islathehut/isla-kbd/README.md

# isla-kbd

This repo is for collecting my keyboard designs.

## Keyboards

* [sandevistan43](./sandevistan43/README.md)

## Development

Run `make` to install submodules.

_NOTE: Designs were made with Kicad 9_
