islathehut/isla-kbd/sandevistan58/README.md

# sandevistan43

A 43-key split keyboard inspired by the [corne](https://github.com/foostan/crkbd), [torn](https://github.com/rtitmuss/torn), and [0xCB Static](https://0xcb.dev/static/).

> :warning: **Warning:** This is very much a work in progress!  Use these designs at your own risk!

# Features

* corne stagger 3x6 main rows
* 4 and 3-key splayed thumb rows
* 2" IPS display
* 34mm-55mm trackball via [vik](https://github.com/sadekbaroudi/vik) and dedicated left and right mouse buttons
* Support for hotswapped Choc V1/V2, Gateron Low Profile KS-27/KS-33, and Cherry MX switches
* RaspberryPi Pico controllers<sup>1</sup>
* Top-mounted through-hole diodes
* [vik](https://github.com/sadekbaroudi/vik) support on the right side allows the use of [any vik module](https://github.com/sadekbaroudi/vik/tree/master/pcb)<sup>2</sup>

_<span style="color:gray"><sup>1</sup>Must use a Pico or Pico-clone with castellated pads</br><sup>2</sup>Firmware modifications are required if using the vik connector for something other than a trackball </span>_

# Materials

| Part Name | Count |
| ---  | --- |
| Choc/MX/GLP Hotswap Sockets | 43 |
| Key Switches | 43 |
| [1N4148 Through-hole Diodes](https://www.digikey.com/en/products/detail/diotec-semiconductor/1N4148/13164514) | 43 |
| [SJ2-35954A-SMT-TR TRRS Jack](https://www.digikey.com/en/products/detail/same-sky-formerly-cui-devices/SJ2-35954A-SMT-TR/6619576) | 2 |
| [TL6340AF160Q Reset Button](https://www.digikey.com/en/products/detail/e-switch/TL6340AF160Q/11684842) | 2 |
| [DFR0664 2" Display](https://www.digikey.com/en/products/detail/dfrobot/DFR0664/13166503) | 1 |
| [Mill-Max 10-pin Socket](https://www.digikey.com/en/products/detail/digikey-va/310-13-110-41-001000/265817) | 1 |
| [Mill-Max 10-pin Header](https://www.digikey.com/en/products/detail/digikey-va/350-10-110-00-006000/4456131) | 1 |
| [Amphenol 12-pin FPC Connector](https://www.digikey.com/en/products/detail/amphenol-cs-fci/F3311A7H121012E200/15287510) | 1 |
| [Amphenol 4-pin FPC Connector](https://www.digikey.com/en/products/detail/amphenol-cs-fci/F3311A7H121004E200/15287508) | 1 |
| 12-pin FFC Cable (same or opposite side orientation works) | 1 |
| 4-pin FFC Cable (same or opposite side orientation works) | 1 |
| 3-pole Mouse Micro Switch (e.g. [Kailh GM](https://www.lethal.gg/products/kailh-gm-2-0-teal-micro-switch-2-pcs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)) | 2 |
| [fingerpunch PMW3360 XS Trackball PCB](https://fingerpunch.xyz/product/vik-pmw3360-trackball-module-xs/) | 1 |
| 34mm Trackball | 1 |
| TRRS Cable | 1 |
| USB-C Cable | 1 |
| Left PCB | 1 |
| Right PCB | 1 |
| Switch plate | 2 |
| Left Base Plate | 1 |
| Right Base Plate | 1 |
| Assorted M2 standoffs and screws | TBD |
| Trackball mount | 1 |

For now the trackball is in development and the mouse keys are one of the next things on my list.

# Firmware

_Coming soon_
