islathehut/isla-kbd/kicad/footprints/Mounting Hole/README.md

# Mounting_Holes.pretty

Credit to https://kicad.github.io/footprints/MountingHole.html
