islathehut/isla-kbd/kicad/footprints/Amphenol F3311A7H121004E200 4-pin FPC Connector/Amphenol F3311A7H121004E200 3D Model STEP 510211.STEP

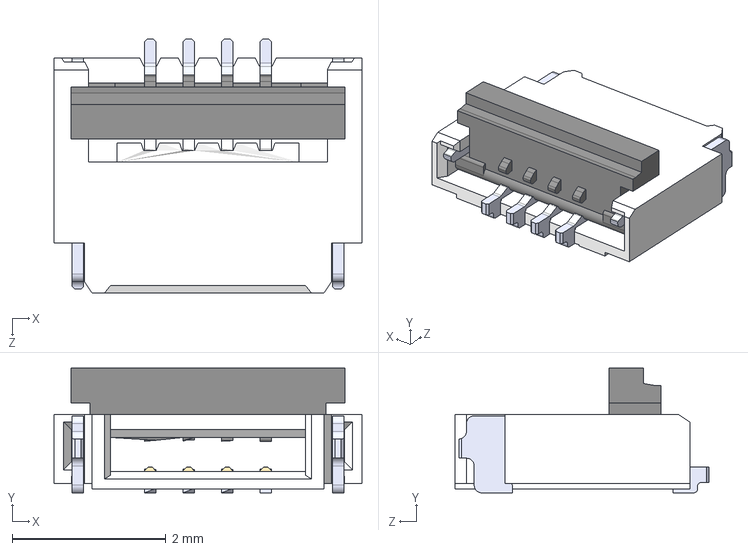
[picture p1: CAD file, 2025-05-30]
kicad/footprints/Amphenol F3311A7H121004E200 4-pin FPC Connector/Amphenol F3311A7H121004E200 3D Model STEP 510211.STEP
4.00 x 1.62 x 3.30 mm
