islathehut/isla-kbd/kicad/footprints/Amphenol F3311A7H121012E200 12-pin FPC Connector/F3311A7H121012E200 3D Model STEP 510211.STEP

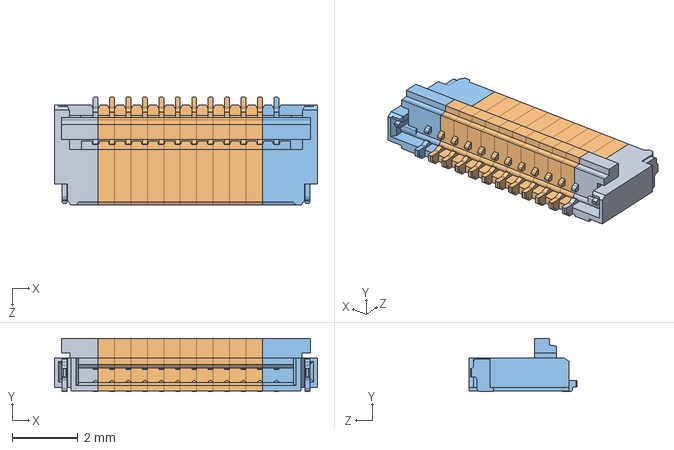
[picture p2: CAD file, 2025-05-30]
kicad/footprints/Amphenol F3311A7H121012E200 12-pin FPC Connector/F3311A7H121012E200 3D Model STEP 510211.STEP
8.00 x 1.62 x 3.30 mm
