islathehut/isla-kbd/kicad/footprints/EVQ-P7C01P/EVQ-P7C01P.step

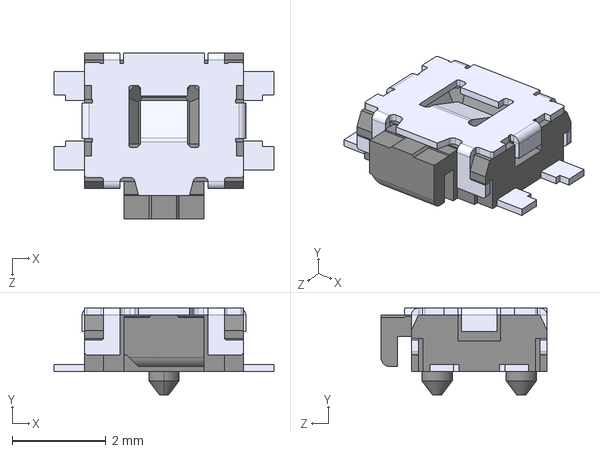
[picture p3: CAD file, 2025-06-11]
kicad/footprints/EVQ-P7C01P/EVQ-P7C01P.step
4.70 x 1.85 x 3.55 mm
