islathehut/isla-kbd/kicad/footprints/PEC11R 4215F Footprint Symbol/PEC11R-4215F-S0024.step

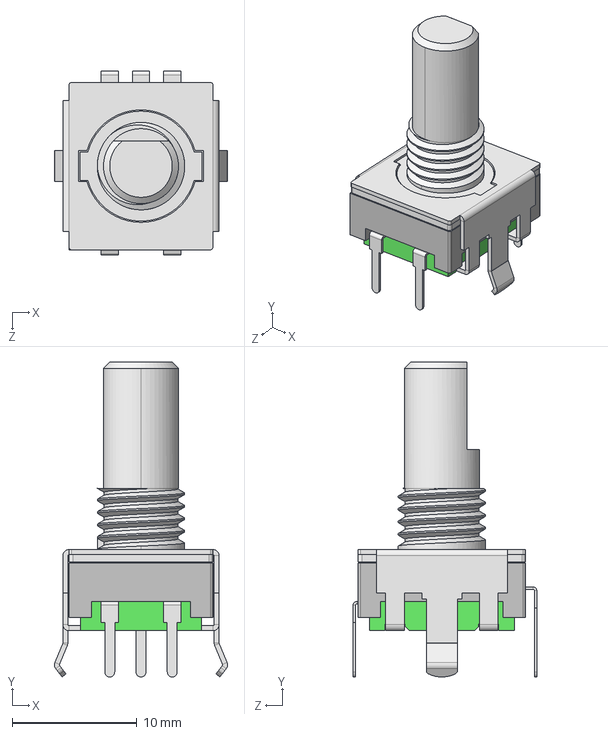
[picture p4: CAD file, 2025-06-02]
kicad/footprints/PEC11R 4215F Footprint Symbol/PEC11R-4215F-S0024.step
13.9 x 25.2 x 14.7 mm
