islathehut/isla-kbd/kicad/footprints/SJ2 35954A SMT TR SMD TRRS Jack/Same_Sky_SJ2-35954A-SMT-TR.step

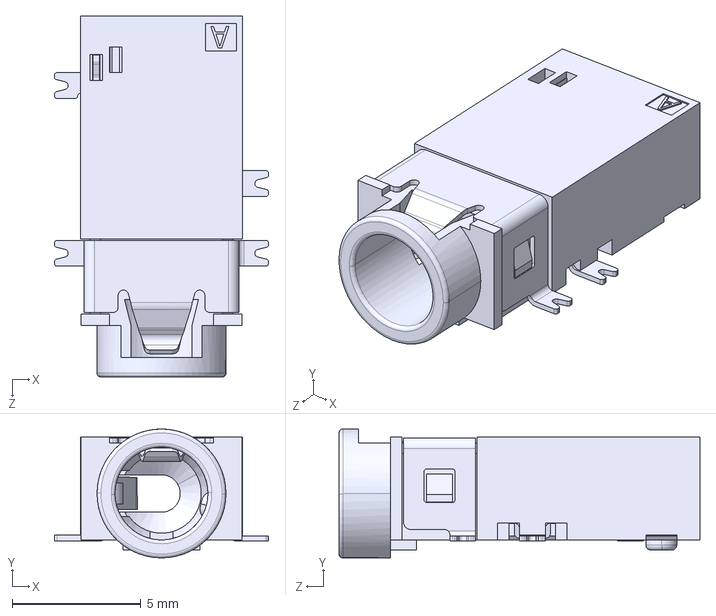
[picture p5: CAD file, 2025-05-30]
kicad/footprints/SJ2 35954A SMT TR SMD TRRS Jack/Same_Sky_SJ2-35954A-SMT-TR.step
8.30 x 5.00 x 14.0 mm
