islathehut/isla-kbd/kicad/footprints/TL6340AF160Q SMD Reset Switch/TL6340AF160Q.step

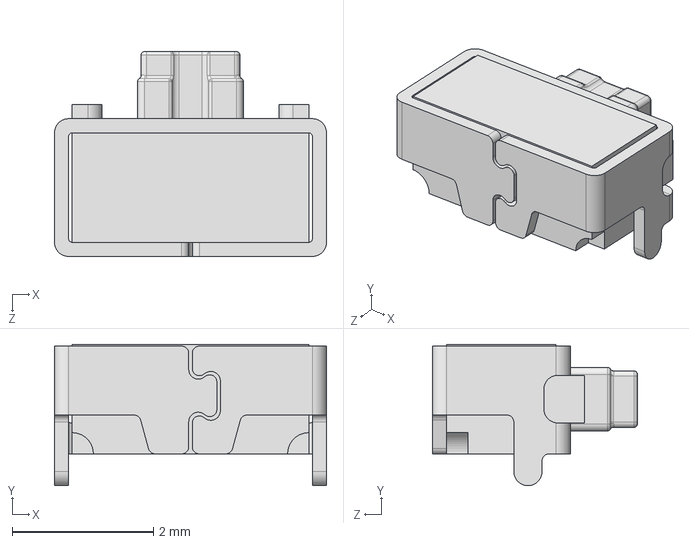
[picture p6: CAD file, 2025-05-30]
kicad/footprints/TL6340AF160Q SMD Reset Switch/TL6340AF160Q.step
3.85 x 2.00 x 2.90 mm
