islathehut/isla-kbd/sandevistan58/stl/trackball/55mm_btu_trackball_ball_mount_v1.stl

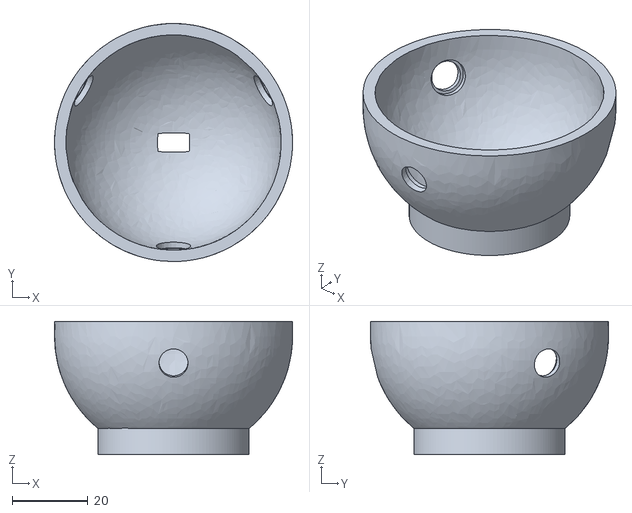
[picture p7: CAD file, 2025-06-11]
sandevistan58/stl/trackball/55mm_btu_trackball_ball_mount_v1.stl
63.0 x 63.0 x 35.3
