islathehut/isla-kbd/kicad/footprints/Amphenol F3311A7H121012E200 12-pin FPC Connector/Molex 3D Model STEP 56544.STEP

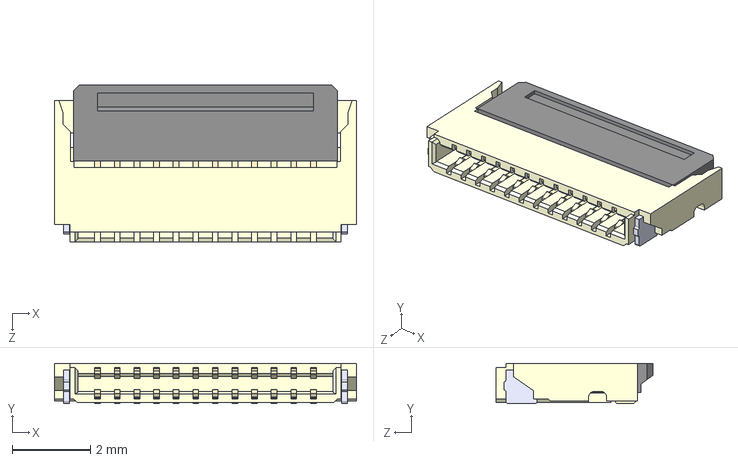
[picture p8: CAD file, 2025-05-30]
kicad/footprints/Amphenol F3311A7H121012E200 12-pin FPC Connector/Molex 3D Model STEP 56544.STEP
7.70 x 1.02 x 4.00 mm
