islathehut/isla-kbd/sandevistan58/stl/trackball/trackball_pcb_mount_v1.stl

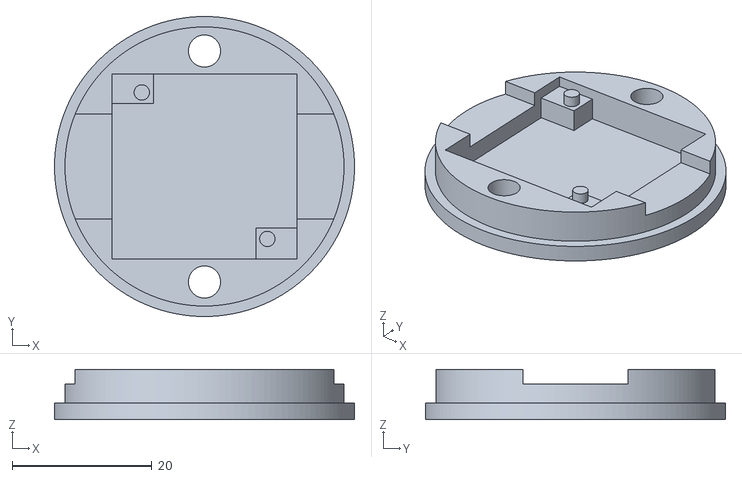
[picture p9: CAD file, 2025-05-30]
sandevistan58/stl/trackball/trackball_pcb_mount_v1.stl
43.0 x 43.0 x 7.19
