islathehut/isla-kbd/sandevistan58/stl/trackball/34mm_btu_trackball_ball_mount_v1.stl

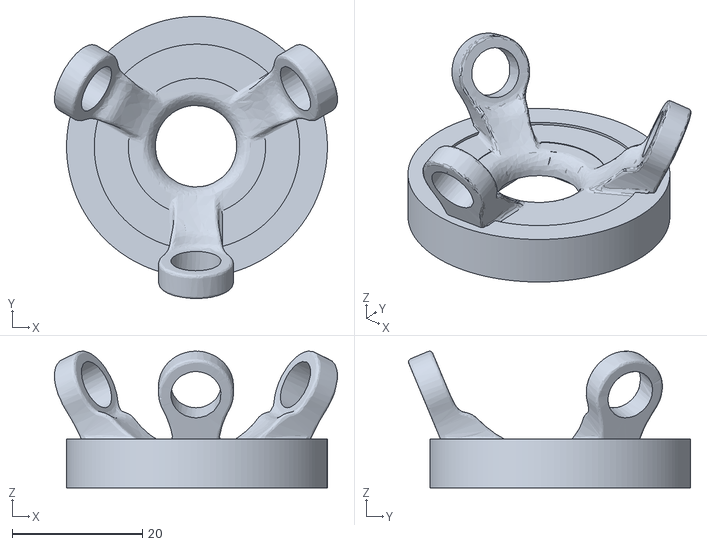
[picture p10: CAD file, 2025-05-30]
sandevistan58/stl/trackball/34mm_btu_trackball_ball_mount_v1.stl
43.4 x 43.3 x 21.0
