islathehut/isla-kbd/sandevistan58/pcb/sandevistan58_right.kicad_sch

## KiCad design sandevistan58/pcb/sandevistan58_right.kicad_sch (2025-06-11)

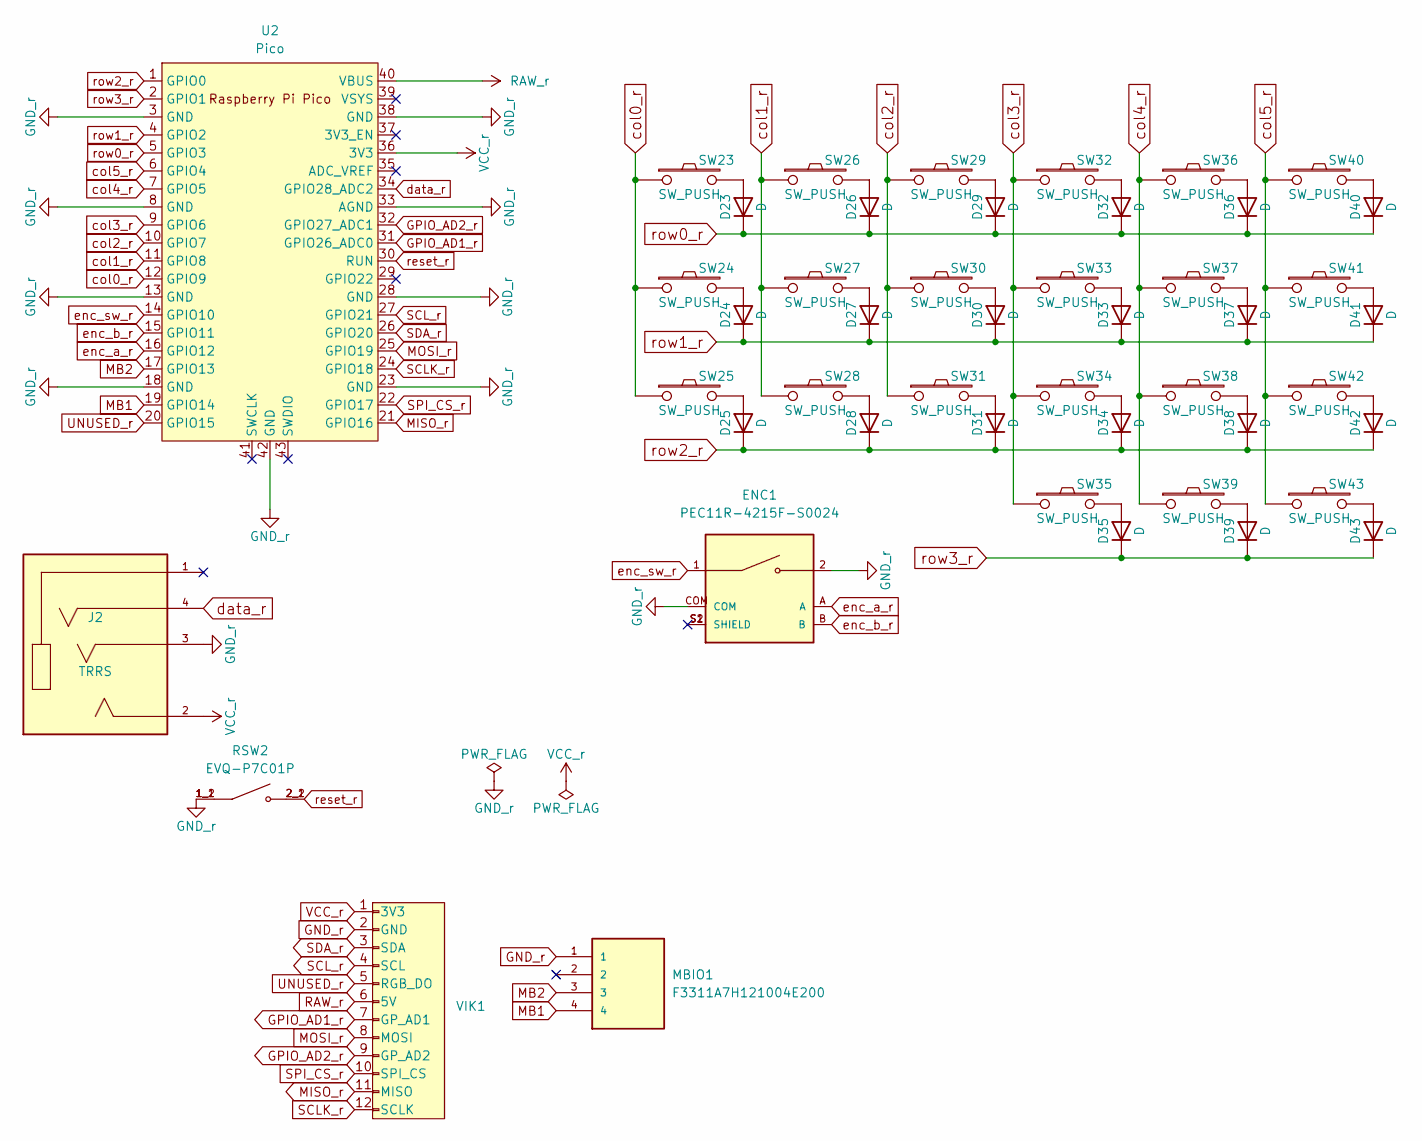
[picture p12: schematic sandevistan58_right.kicad_sch]

Parts:
D23, D24, D25, D26, D27, D28, D29, D30, D31, D32, D33, D34, D35, D36, D37, D38, D39, D40, D41, D42, D43: D; TH 1N4148 Diode (long)
ENC1: PEC11R-4215F-S0024; PEC11R_23mm_knob; PARTREV Rev. 09/19
J2: TRRS; CUI_SJ2-35954A-SMT-TR; PARTREV 1.04
MBIO1: F3311A7H121004E200; AMPHENOL_F3311A7H121004E200; PARTREV A
RSW2: EVQ-P7C01P; SW_EVQ-P7C01P; PARTREV 2022.4
SW23, SW24, SW25, SW26, SW27, SW28, SW29, SW30, SW31, SW32, SW33, SW34, SW35, SW36, SW37, SW38, SW39, SW40, SW41, SW42: SW_PUSH; Universal Switch Footprint (1u)
SW43: SW_PUSH; Universal Switch Footprint (1.5u)
U2: Pico; RPi_Pico_SMD_TH_no_through_holes
VIK1: vik-keyboard-connector-horizontal-mini

Connections:
GND_r: ENC1.2, ENC1.COM, J2.3, MBIO1.1, RSW2.1_1, RSW2.1_2, U2.3 (GND), U2.8 (GND), U2.13 (GND), U2.18 (GND), U2.23 (GND), U2.28 (GND), U2.33 (AGND), U2.38 (GND), U2.42 (GND), VIK1.2 (GND)
GPIO_AD1_r: U2.31 (GPIO26_ADC0), VIK1.7 (GP_AD1)
GPIO_AD2_r: U2.32 (GPIO27_ADC1), VIK1.9 (GP_AD2)
MB1: MBIO1.4, U2.19 (GPIO14)
MB2: MBIO1.3, U2.17 (GPIO13)
MISO_r: U2.21 (GPIO16), VIK1.11 (MISO)
MOSI_r: U2.25 (GPIO19), VIK1.8 (MOSI)
unnamed: D23.2 (A), SW23.2
unnamed: D24.2 (A), SW24.2
unnamed: D25.2 (A), SW25.2
unnamed: D26.2 (A), SW26.2
unnamed: D27.2 (A), SW27.2
unnamed: D28.2 (A), SW28.2
unnamed: D29.2 (A), SW29.2
unnamed: D30.2 (A), SW30.2
unnamed: D31.2 (A), SW31.2
unnamed: D32.2 (A), SW32.2
unnamed: D33.2 (A), SW33.2
unnamed: D34.2 (A), SW34.2
unnamed: D35.2 (A), SW35.2
unnamed: D36.2 (A), SW36.2
unnamed: D37.2 (A), SW37.2
unnamed: D38.2 (A), SW38.2
unnamed: D39.2 (A), SW39.2
unnamed: D40.2 (A), SW40.2
unnamed: D41.2 (A), SW41.2
unnamed: D42.2 (A), SW42.2
unnamed: D43.2 (A), SW43.2
unnamed: ENC1.S1 (SHIELD), ENC1.S2 (SHIELD)
RAW_r: U2.40 (VBUS), VIK1.6 (5V)
SCLK_r: U2.24 (GPIO18), VIK1.12 (SCLK)
SCL_r: U2.27 (GPIO21), VIK1.4 (SCL)
SDA_r: U2.26 (GPIO20), VIK1.3 (SDA)
SPI_CS_r: U2.22 (GPIO17), VIK1.10 (SPI_CS)
UNUSED_r: U2.20 (GPIO15), VIK1.5 (RGB_DO)
VCC_r: J2.2, U2.36 (3V3), VIK1.1 (3V3)
col0_r: SW23.1, SW24.1, SW25.1, U2.12 (GPIO9)
col1_r: SW26.1, SW27.1, SW28.1, U2.11 (GPIO8)
col2_r: SW29.1, SW30.1, SW31.1, U2.10 (GPIO7)
col3_r: SW32.1, SW33.1, SW34.1, SW35.1, U2.9 (GPIO6)
col4_r: SW36.1, SW37.1, SW38.1, SW39.1, U2.7 (GPIO5)
col5_r: SW40.1, SW41.1, SW42.1, SW43.1, U2.6 (GPIO4)
data_r: J2.4, U2.34 (GPIO28_ADC2)
enc_a_r: ENC1.A, U2.16 (GPIO12)
enc_b_r: ENC1.B, U2.15 (GPIO11)
enc_sw_r: ENC1.1, U2.14 (GPIO10)
reset_r: RSW2.2_1, RSW2.2_2, U2.30 (RUN)
row0_r: D23.1 (K), D26.1 (K), D29.1 (K), D32.1 (K), D36.1 (K), D40.1 (K), U2.5 (GPIO3)
row1_r: D24.1 (K), D27.1 (K), D30.1 (K), D33.1 (K), D37.1 (K), D41.1 (K), U2.4 (GPIO2)
row2_r: D25.1 (K), D28.1 (K), D31.1 (K), D34.1 (K), D38.1 (K), D42.1 (K), U2.1 (GPIO0)
row3_r: D35.1 (K), D39.1 (K), D43.1 (K), U2.2 (GPIO1)
