islathehut/isla-kbd/sandevistan43/pcb/sandevistan43_left.kicad_sch

## KiCad design sandevistan43/pcb/sandevistan43_left.kicad_sch (2025-06-11)

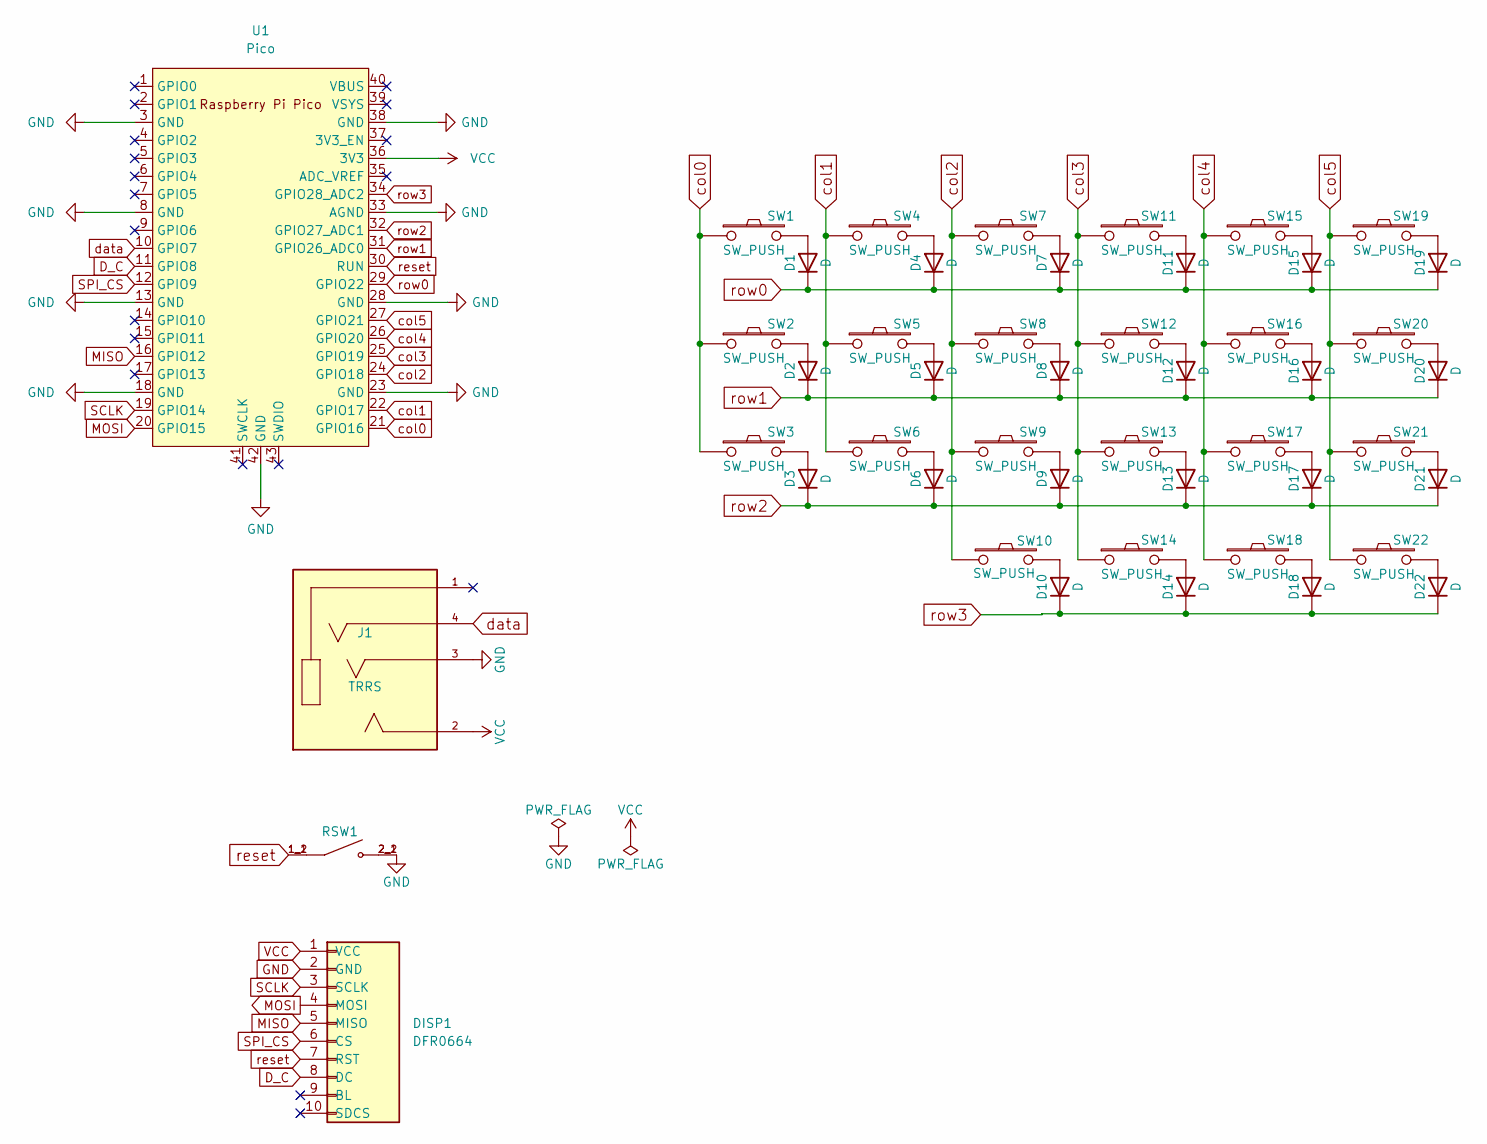
[picture p13: schematic sandevistan43_left.kicad_sch]

Parts:
D1, D2, D3, D4, D5, D6, D7, D8, D9, D10, D11, D12, D13, D14, D15, D16, D17, D18, D19, D20, D21, D22: D; TH 1N4148 Diode (long)
DISP1: DFR0664; DFR0664_2in_RGB_TFT_Display
J1: TRRS; CUI_SJ2-35954A-SMT-TR; PARTREV 1.04
RSW1: SW_PUSH; SW_EVQ-P7C01P; PARTREV 2022.4
SW1, SW2, SW3, SW4, SW5, SW6, SW7, SW8, SW9, SW10, SW11, SW12, SW13, SW14, SW15, SW16, SW17, SW18, SW19, SW20, SW21: SW_PUSH; Universal Switch Footprint (1u)
SW22: SW_PUSH; Universal Switch Footprint (1.5u)
U1: Pico; RPi_Pico_SMD_TH_no_through_holes

Connections:
D_C: DISP1.8 (DC), U1.11 (GPIO8)
GND: DISP1.2 (GND), J1.3, RSW1.2_1, RSW1.2_2, U1.3 (GND), U1.8 (GND), U1.13 (GND), U1.18 (GND), U1.23 (GND), U1.28 (GND), U1.33 (AGND), U1.38 (GND), U1.42 (GND)
MISO: DISP1.5 (MISO), U1.16 (GPIO12)
MOSI: DISP1.4 (MOSI), U1.20 (GPIO15)
unnamed: D1.2 (A), SW1.2
unnamed: D2.2 (A), SW2.2
unnamed: D3.2 (A), SW3.2
unnamed: D4.2 (A), SW4.2
unnamed: D5.2 (A), SW5.2
unnamed: D6.2 (A), SW6.2
unnamed: D7.2 (A), SW7.2
unnamed: D8.2 (A), SW8.2
unnamed: D9.2 (A), SW9.2
unnamed: D10.2 (A), SW10.2
unnamed: D11.2 (A), SW11.2
unnamed: D12.2 (A), SW12.2
unnamed: D13.2 (A), SW13.2
unnamed: D14.2 (A), SW14.2
unnamed: D15.2 (A), SW15.2
unnamed: D16.2 (A), SW16.2
unnamed: D17.2 (A), SW17.2
unnamed: D18.2 (A), SW18.2
unnamed: D19.2 (A), SW19.2
unnamed: D20.2 (A), SW20.2
unnamed: D21.2 (A), SW21.2
unnamed: D22.2 (A), SW22.2
SCLK: DISP1.3 (SCLK), U1.19 (GPIO14)
SPI_CS: DISP1.6 (CS), U1.12 (GPIO9)
VCC: DISP1.1 (VCC), J1.2, U1.36 (3V3)
col0: SW1.1, SW2.1, SW3.1, U1.21 (GPIO16)
col1: SW4.1, SW5.1, SW6.1, U1.22 (GPIO17)
col2: SW7.1, SW8.1, SW9.1, SW10.1, U1.24 (GPIO18)
col3: SW11.1, SW12.1, SW13.1, SW14.1, U1.25 (GPIO19)
col4: SW15.1, SW16.1, SW17.1, SW18.1, U1.26 (GPIO20)
col5: SW19.1, SW20.1, SW21.1, SW22.1, U1.27 (GPIO21)
data: J1.4, U1.10 (GPIO7)
reset: DISP1.7 (RST), RSW1.1_1, RSW1.1_2, U1.30 (RUN)
row0: D1.1 (K), D4.1 (K), D7.1 (K), D11.1 (K), D15.1 (K), D19.1 (K), U1.29 (GPIO22)
row1: D2.1 (K), D5.1 (K), D8.1 (K), D12.1 (K), D16.1 (K), D20.1 (K), U1.31 (GPIO26_ADC0)
row2: D3.1 (K), D6.1 (K), D9.1 (K), D13.1 (K), D17.1 (K), D21.1 (K), U1.32 (GPIO27_ADC1)
row3: D10.1 (K), D14.1 (K), D18.1 (K), D22.1 (K), U1.34 (GPIO28_ADC2)
