islathehut/isla-kbd/(commit log)

2025-05-31 Start rev0.2 build
    - pi pico replaces pro micro style mcu
    - mcu now on underside
    - rewire for simplicity
    - update switch footprints to allow choc, mx, gateron lp
    [sandevistan44_left.kicad_sch]
2025-06-02 Finish first iteration of 0.2 configuration
    - Add encoders on each side and add body extension
    - Modify trackball module cutout to allow for up to 55mm trackball
    - Rewire again to fit new layout
    - Fix/cleanup footprints
    - Rework standoff holes to fit with new switch footprints
    [PEC11R-4215F-S0024.step, sandevistan44_left.kicad_sch, sandevistan44_right.kicad_sch]
2025-06-03 Rework right side encoder layout
2025-06-06 Finalize left and right board setups
    - Rework thumb cluster layout left and right
    - Rework board shape on left and right
    - Remove encoder from left side
    - Rework wiring for better cleanliness/safety
    - Reposition some standoff holes
    - Move mouse button FFC connector
    - Repin MCUs left and right for better routing
    [sandevistan44_left.kicad_sch, sandevistan44_right.kicad_sch]
2025-06-10 Rename to sandevistan43, modify layout, update README
    - Rename files to sandevistan43 to reflect actual key count
    - Shift thumb keys over to be closer to torn keyboard's positioning
    - Rewire switches
    - Shift encoder
    - Reconfigure encoder footprint to assume a 26mm wide knob
    - Update readme to reflect latest configuration
    [34mm_btu_trackball_ball_mount_v1.stl, 34mm_btu_trackball_pcb_mount_v1.stl, Amphenol F3311A7H121004E200 3D Model STEP 510211.STEP, F3311A7H121004E200.step, F3311A7H121012E200 3D Model STEP 510211.STEP, F3311A7H121012E200.step, Molex 3D Model STEP 56544.STEP, PEC11R-4215F-S0024.step]
2025-06-11 Make footprints/symbols common and use easier to solder reset button
    [Amphenol F3311A7H121004E200 3D Model STEP 510211.STEP, EVQ-P7C01P.step, F3311A7H121004E200.step, F3311A7H121012E200 3D Model STEP 510211.STEP, F3311A7H121012E200.step, Molex 3D Model STEP 56544.STEP, PEC11R-4215F-S0024.step, SJ2-35954A-SMT-TR.step]
2025-06-11 Update trackball STLs
    [55mm_btu_trackball_ball_mount_v1.stl, trackball_pcb_mount_v1.stl]
2025-06-11 Start of a 58 key board
    [34mm_btu_trackball_ball_mount_v1.stl, 55mm_btu_trackball_ball_mount_v1.stl, sandevistan44_left_plate.kicad_pcb, sandevistan44_left_switch_plate.kicad_pcb, sandevistan44_right_plate.kicad_pcb, sandevistan44_right_switch_plate.kicad_pcb, sandevistan58_left.kicad_sch, sandevistan58_right.kicad_sch]
